bastl-instruments/60Knobs/Schematics/README.md

Schematic and Board developed in Autodesk Eagle

CC-BY-SA Bastl Instruments
