bastl-instruments/60Knobs/sixtyknobs/Readme.md

# 60 Knobs Firmware

Completely written in Arduino  
Depends on [MIDI Library](https://playground.arduino.cc/Main/MIDILibrary) and [EEPROM Library](https://www.arduino.cc/en/Reference/EEPROM)

CC-BY-SA Bastl-Instruments
