bastl-instruments/60Knobs/Enclosure/README.md

60Knobs Enclosure PDF (editable) vector files for Laser-cutting
