bastl-instruments/60Knobs/(threads)

Thread 4 (2019-10-21):

Possibility to change the labels on the panel ?

0mars, 2019-10-21:
Is it possible to change the labels, and do you have source files to 3d print it or something? or how did you go about having the enclosure, thanks

0mars, 2019-10-26:
I saw the source of the panel, so is it ready for the CNC machine if the same dimensions were maintained ?

Thread 5 (2020-07-23):

DIY: Replacing Pots with Buttons

PaeiChe, 2020-07-23:
Is it possible to replace a row of pots with buttons or would there need to be a change to the PCB?
Thanks!
