bastl-instruments/60Knobs/Schematics/60knobs_1.1_schematic.pdf

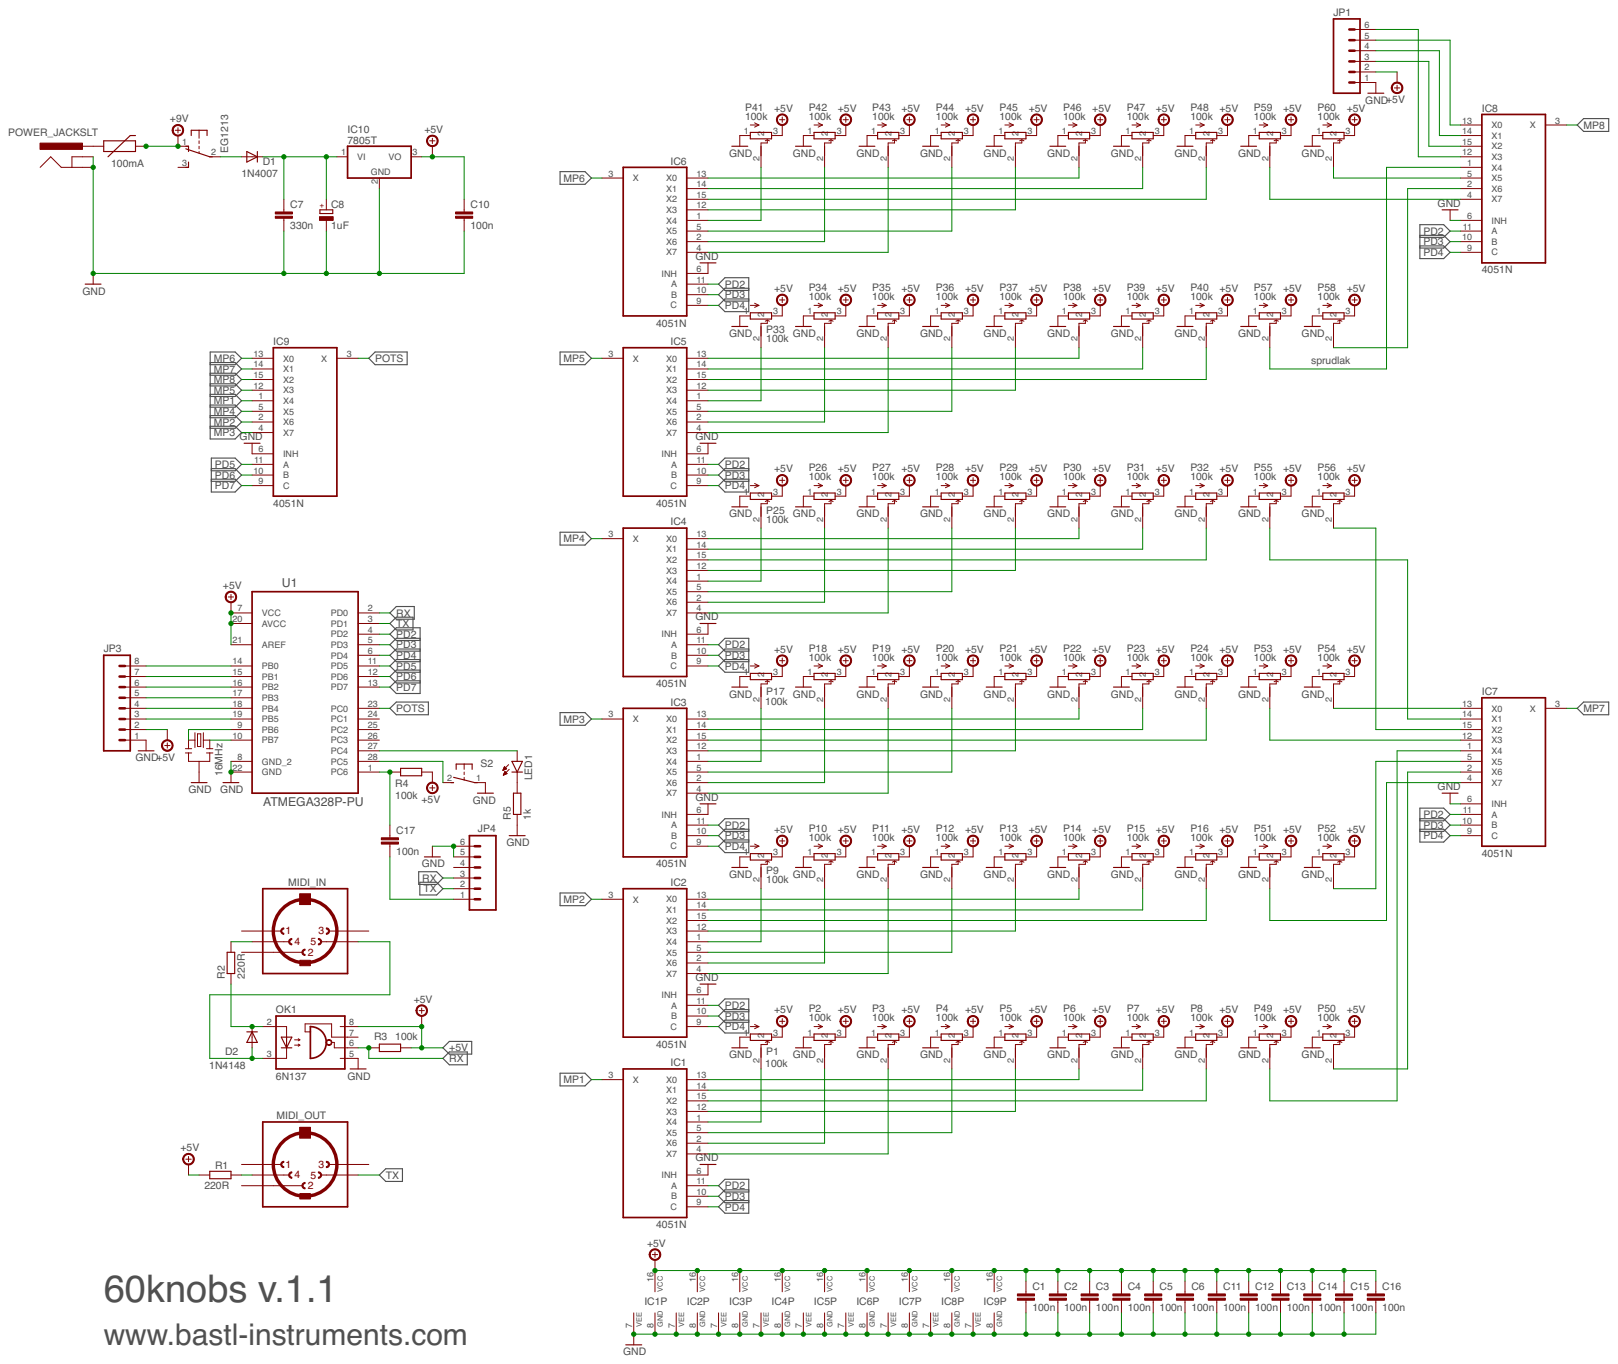
[picture p1: page 1]

GND

12 X0
14 X2 15

60knobs v.1.1
www.bastl-instruments.com
