bastl-instruments/60Knobs/Schematics/60knobs_1.1_board_btm.pdf

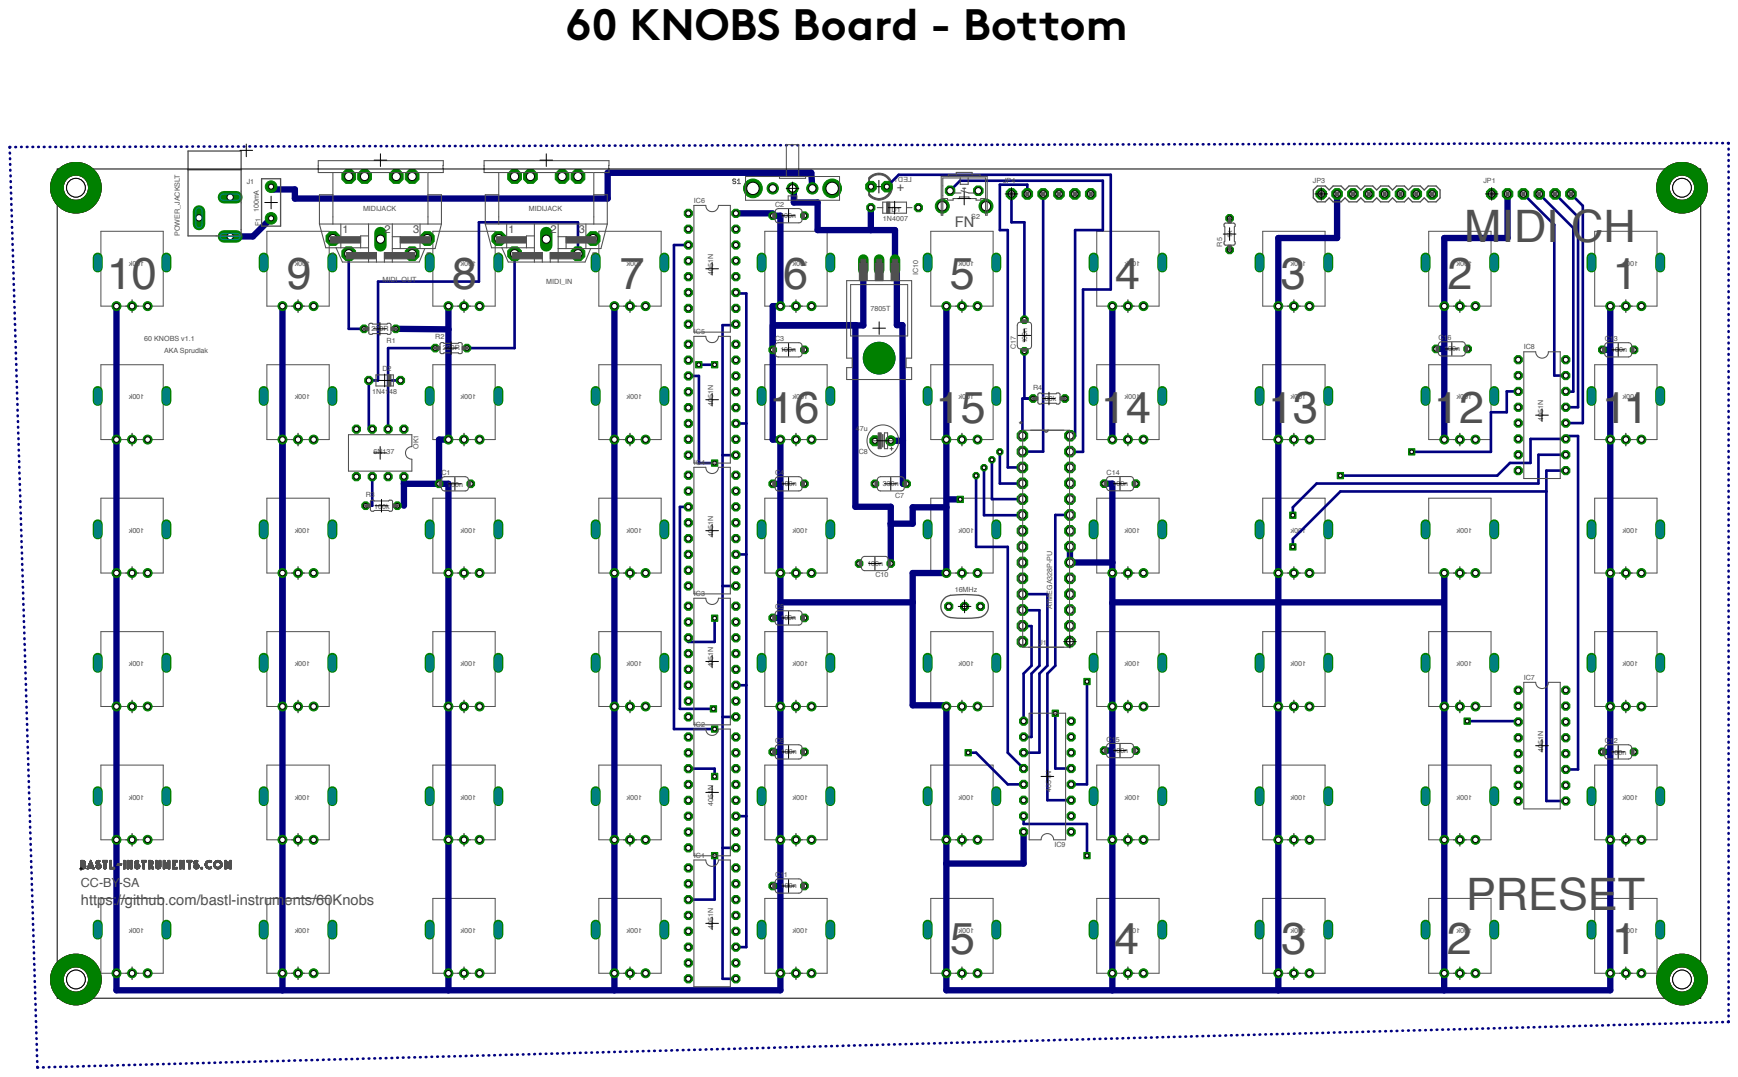
[picture p3: page 1]

PRESET CC-BY-SA
https://github.com/bastl-instruments/60Knobs
