bastl-instruments/60Knobs/Schematics/60knobs_1.1_board_top.pdf

+
10 | 9 | 8 | 7 | 6 | 5 | 4 | 3 | 2 | 1

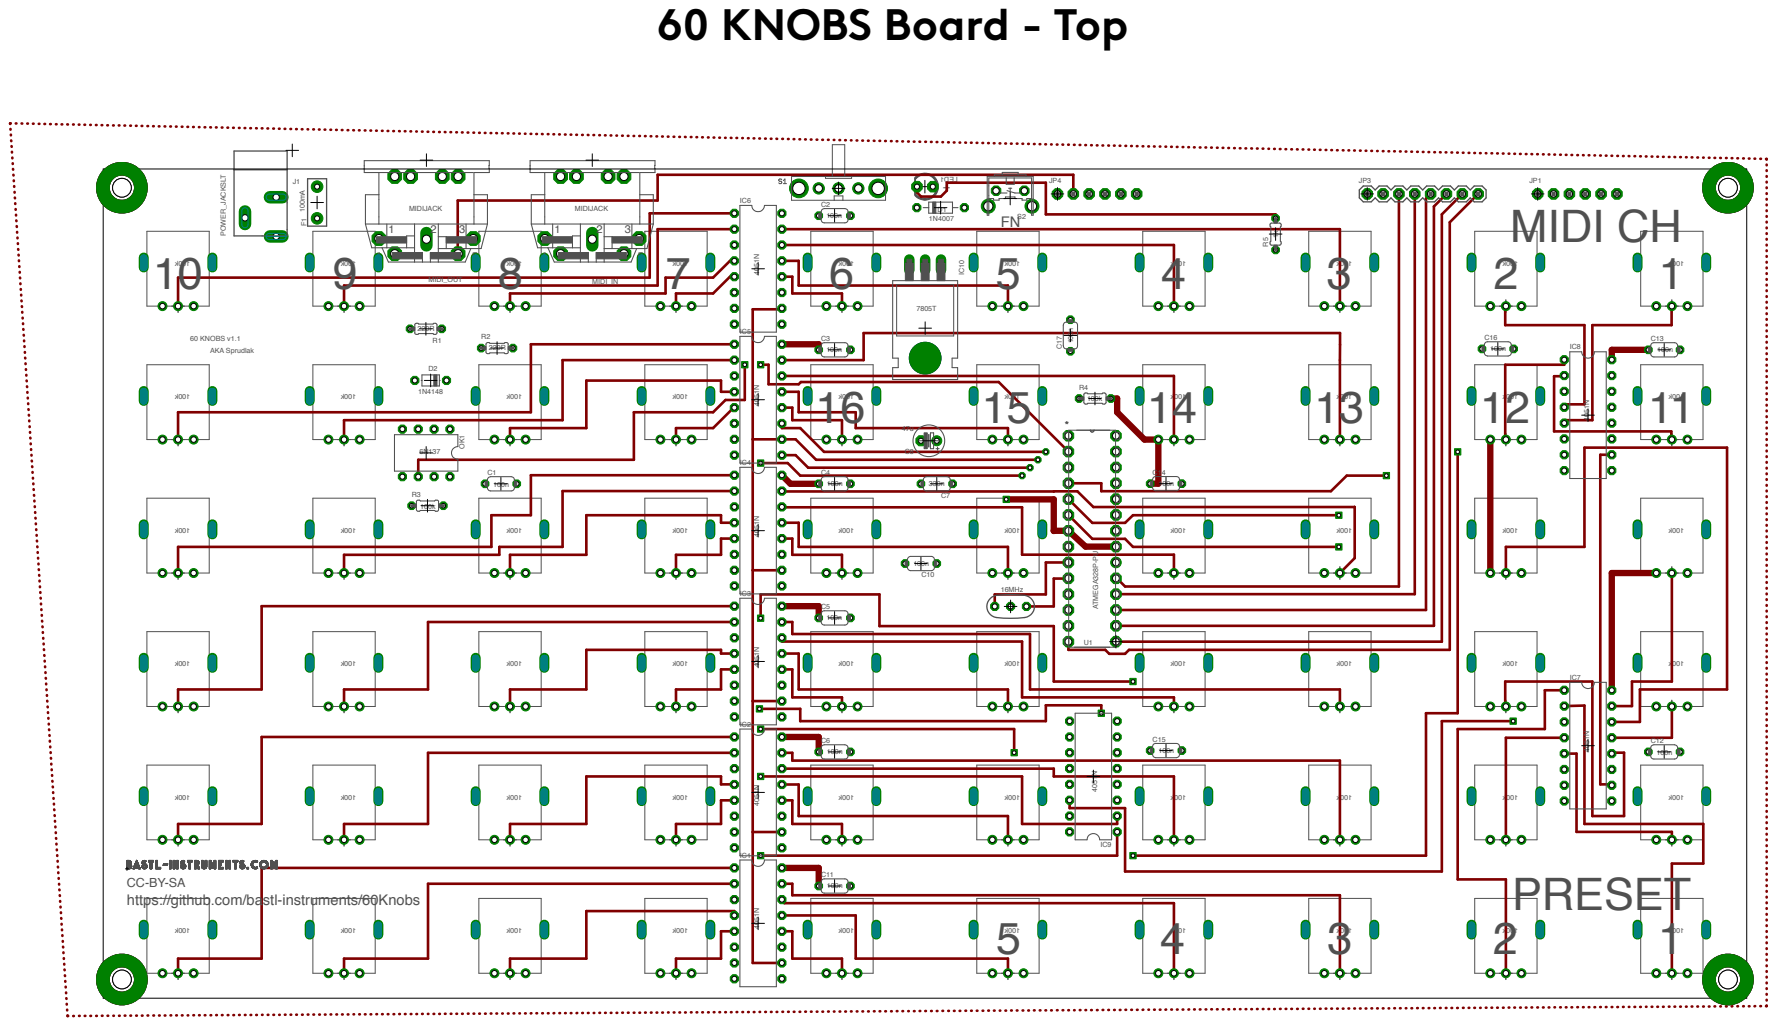
[picture p4: page 1]

MIDI_OUT | MIDI_IN

PRESET CC-BY-SA
https://github.com/bastl-instruments/60Knobs
