bastl-instruments/60Knobs/Enclosure/60_knobs_1.5-CASE-vectors.pdf

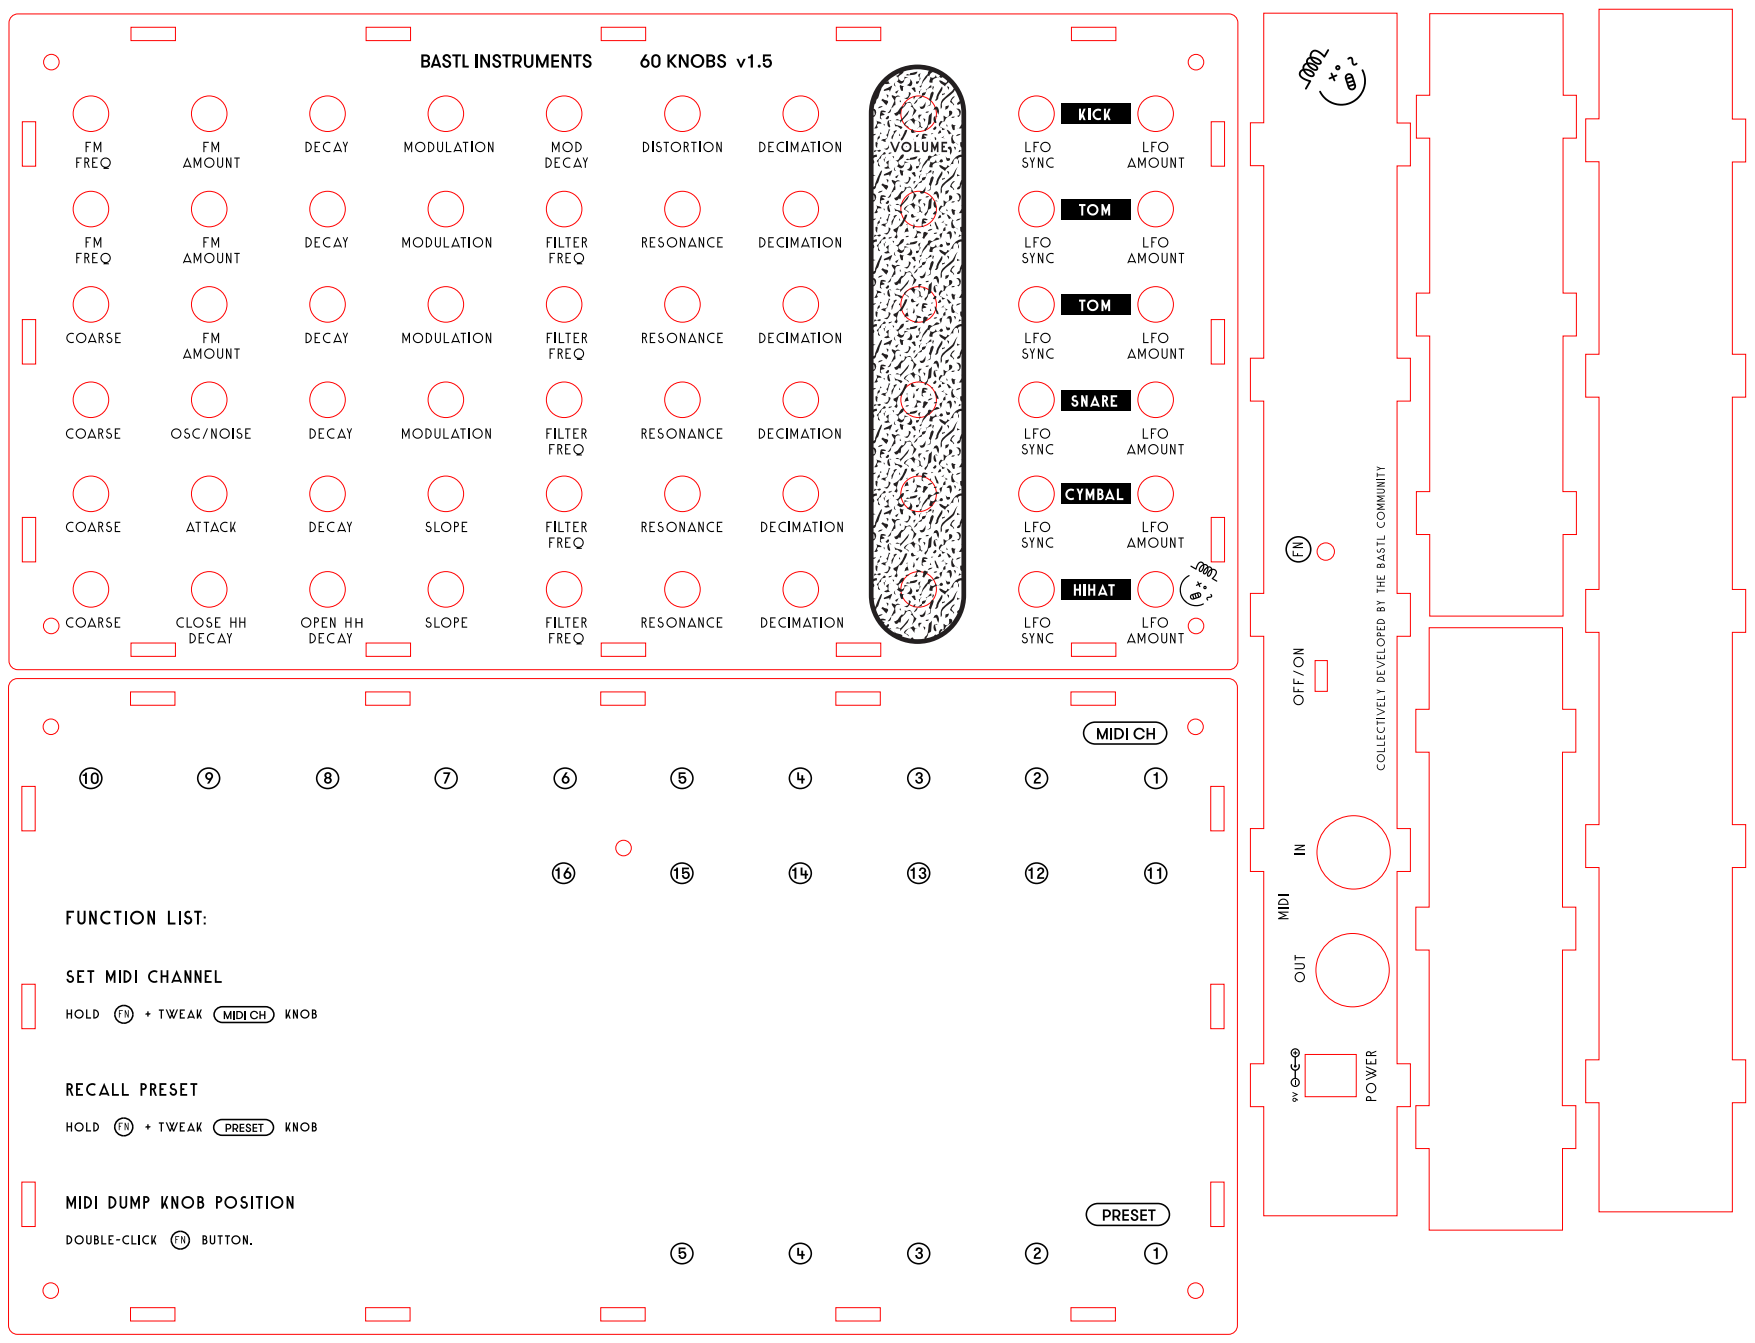
[picture p5: page 1]
