bastl-instruments/60Knobs/Enclosure/60_knobs_1.5-LXR-CASE-vectors.pdf

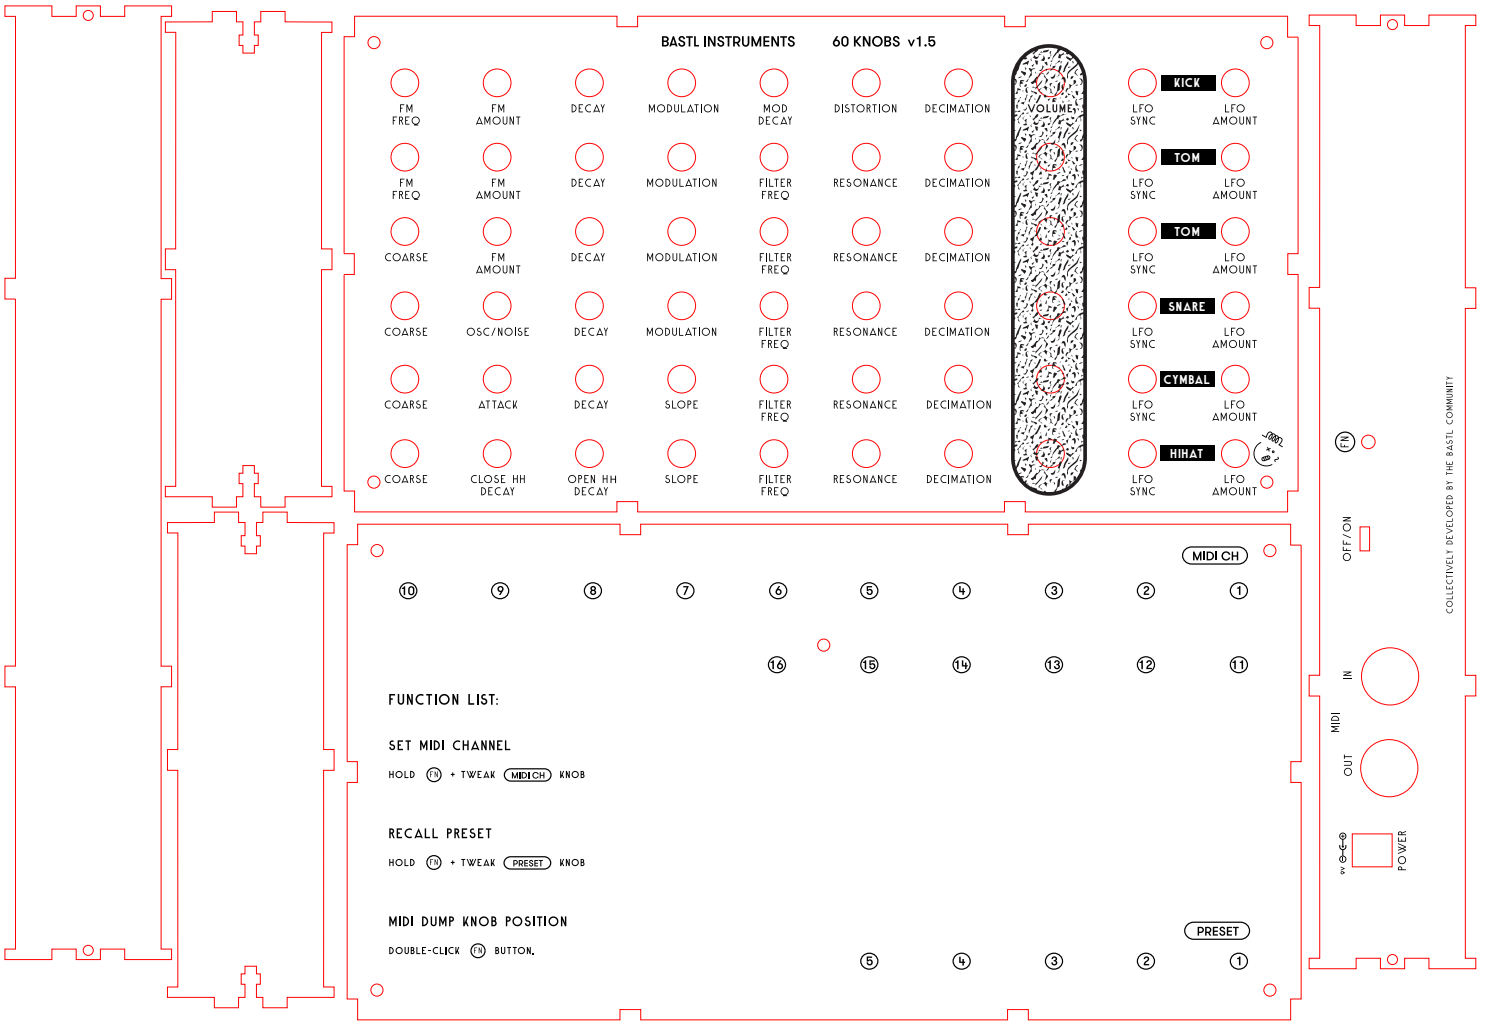
[picture p6: page 1]
KICK; TOM; SNARE; CYMBAL; HIHAT
