bastl-instruments/60Knobs/sixtyknobs/storage.ino

//checks if the machine starts up for the first time and loads the factory presets if needed
bool isEEPROMvalid() {
  //we check if this is the first startup of the machine
  uint8_t byte1, byte2, byte3;

  byte1 = EEPROM.read(EEPROM.length() - 3);
  byte2 = EEPROM.read(EEPROM.length() - 2);
  byte3 = EEPROM.read(EEPROM.length() - 1);

  //if this is the first time this device is powered on
  return ((byte1 == sigByteOne) && (byte2 == sigByteTwo) && (byte3 == sigByteThree));
}

void formatFactory() {
  
  // set last used preset to number 0
  EEPROM.update(lastUsedPresetAddress, 0);
  
  // Create default preset
  Preset_t defaultPreset;
  defaultPreset.channel = 1;

    defaultPreset.knobInfo[0].CC = 84;
    defaultPreset.knobInfo[0].NRPN = 0;
    defaultPreset.knobInfo[0].SYSEX = 128;
    defaultPreset.knobInfo[1].CC = 83;
    defaultPreset.knobInfo[1].NRPN = 0;
    defaultPreset.knobInfo[1].SYSEX = 128;
    defaultPreset.knobInfo[2].CC = 51;
    defaultPreset.knobInfo[2].NRPN = 0;
    defaultPreset.knobInfo[2].SYSEX = 128;
    defaultPreset.knobInfo[3].CC = 75;
    defaultPreset.knobInfo[3].NRPN = 0;
    defaultPreset.knobInfo[3].SYSEX = 128;
    defaultPreset.knobInfo[4].CC = 71;
    defaultPreset.knobInfo[4].NRPN = 0;
    defaultPreset.knobInfo[4].SYSEX = 128;
    defaultPreset.knobInfo[5].CC = 103;
    defaultPreset.knobInfo[5].NRPN = 0;
    defaultPreset.knobInfo[5].SYSEX = 128;
    defaultPreset.knobInfo[6].CC = 109;
    defaultPreset.knobInfo[6].NRPN = 0;
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
    }
  }
  
  //we write the signature so that the device will never rewrite the factory presets
  EEPROM.update(EEPROM.length() - 3, sigByteOne);
  EEPROM.update(EEPROM.length() - 2, sigByteTwo);
  EEPROM.update(EEPROM.length() - 1, sigByteThree);
}


//Loads the specified preset in the RAM and make it the last used preset
void loadPreset(uint8_t presetNumber) {
  
  uint16_t baseAddress = 1 + (presetNumber * sizeof(Preset_t));

  // read the active preset from EEPROM; byte by byte  
  for (uint16_t byteIndex=0; byteIndex<sizeof(Preset_t); byteIndex++) {
    ((uint8_t*)(&activePreset))[byteIndex] = EEPROM.read(baseAddress + byteIndex);
  }

  //update the last used preset
  currentPresetNumber = presetNumber;
  EEPROM.update(lastUsedPresetAddress, currentPresetNumber);
}



void savePreset(uint8_t presetNbr)
{
  uint16_t baseAddress = presetNbr * sizeof(Preset_t) + 1;

  // write the active preset to EEPROM; byte by byte  
  for (uint16_t byteIndex=0; byteIndex<sizeof(Preset_t); byteIndex++) {
    EEPROM.update(baseAddress + byteIndex, ((uint8_t*)(&activePreset))[byteIndex]);
  }
  
  //Visual feedback
  //we wait a bit with the LED oon
  digitalWrite(LED_PIN, HIGH);
  delay(1000);
  //we blink it
  digitalWrite(LED_PIN, LOW);
  delay(250);
  digitalWrite(LED_PIN, HIGH);
  delay(250);
  digitalWrite(LED_PIN, LOW);
}
