bastl-instruments/60Knobs/(commit log)

2017-03-09 change name of main ino file to comply with arduino's conventions
2017-04-23 initialize all presets on factory reset (and not only the first one)
    [definitions.h, storage.ino]
2017-05-22 Update storage.ino
    missing pot #57 and mistake on 3rd row in factory preset
    [storage.ino]
2017-05-31 no need for function prototypes in arduino and no need for includes in files not the main file
2017-05-31 blink LED 5 times when formatting memory
2017-07-25 define EEPROM validation chunk globally to allow changes when memory structure changed and current EEPROM content needs to be invalided
2019-09-25 modified the code to work with yamaha reface DX
    if you want to control yamaha reface DX you will have to open the code in arduino, modify it and re-flash your 60knobs.
    the modification is done in the functions.ino tab in the interpret function. comment out the DX7 function and uncomment the refaceDX function. have fun
